AnnaAlina/4-story-Elevator_PLC-Arduino/Elevator Pictures/Elevator Front.jpg

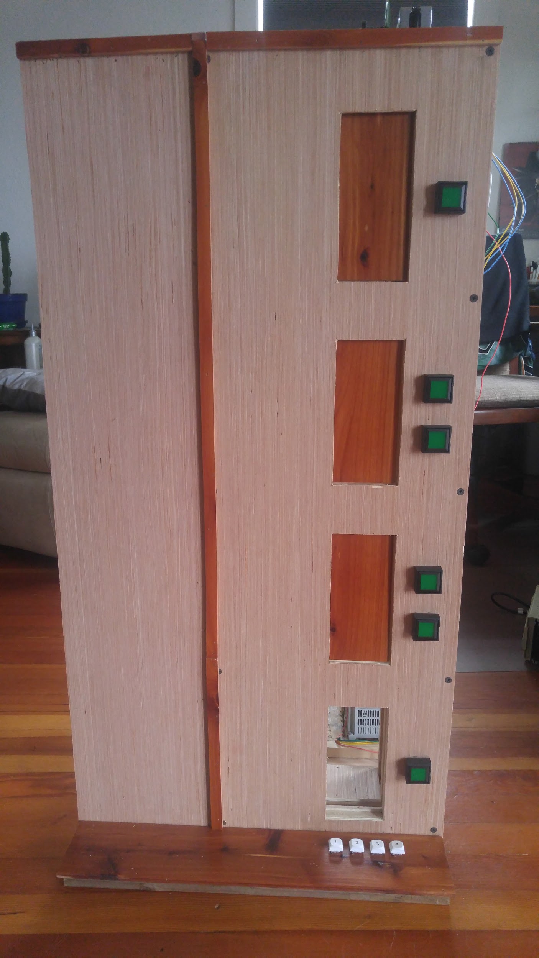
Elevator Pictures/Elevator Front.jpg
