AnnaAlina/4-story-Elevator_PLC-Arduino/Elevator Pictures/Motor and pulley.png

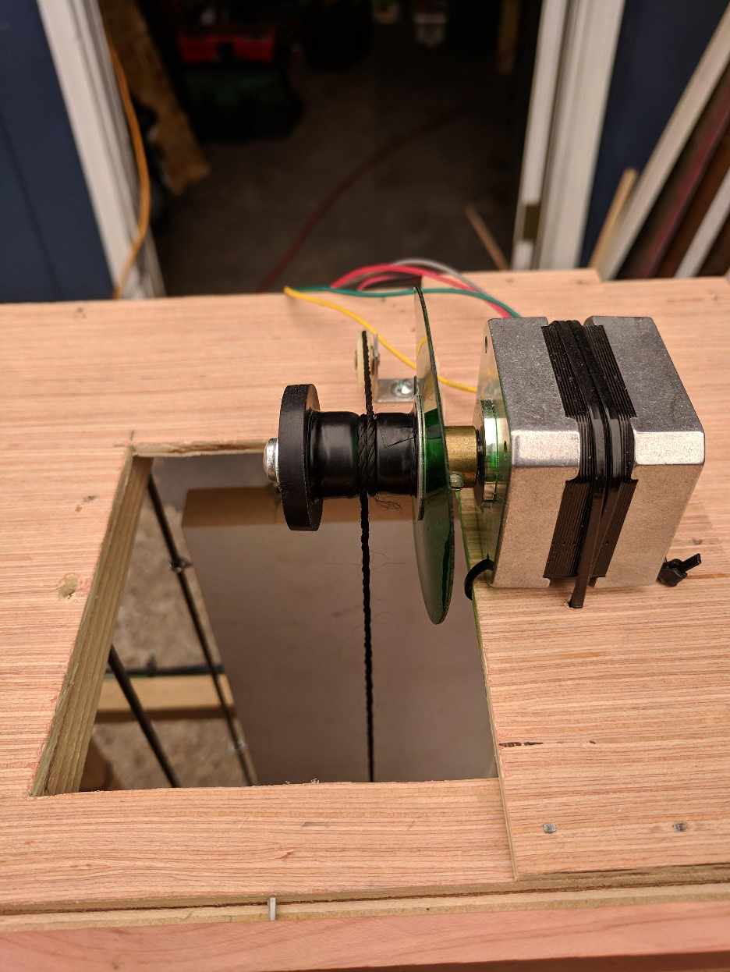
Elevator Pictures/Motor and pulley.png
