AnnaAlina/4-story-Elevator_PLC-Arduino/Elevator Flow charts and Block Diagrams/Block Diagram.jpg

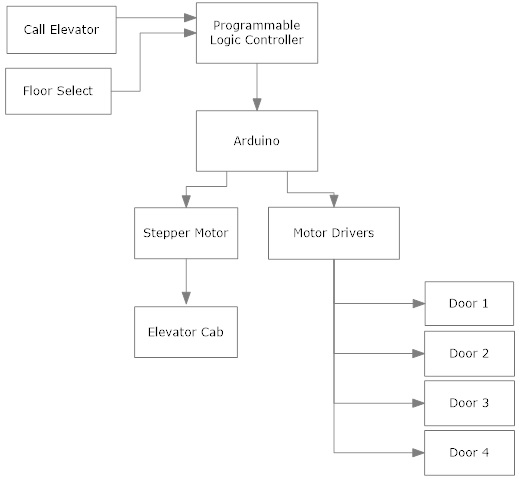
Elevator Flow charts and Block Diagrams/Block Diagram.jpg
