AnnaAlina/4-story-Elevator_PLC-Arduino/Elevator Flow charts and Block Diagrams/Connection Diagram.png

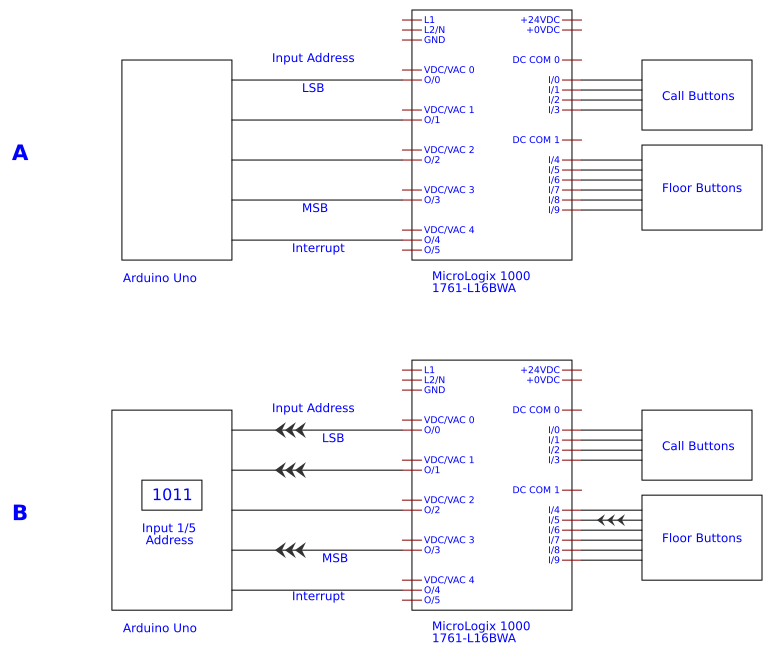
Elevator Flow charts and Block Diagrams/Connection Diagram.png
