AnnaAlina/4-story-Elevator_PLC-Arduino/Elevator Flow charts and Block Diagrams/UpDown Button Pinout.jpg

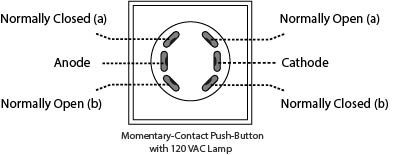
Elevator Flow charts and Block Diagrams/UpDown Button Pinout.jpg
