AnnaAlina/4-story-Elevator_PLC-Arduino/Schematic_Elevator.png

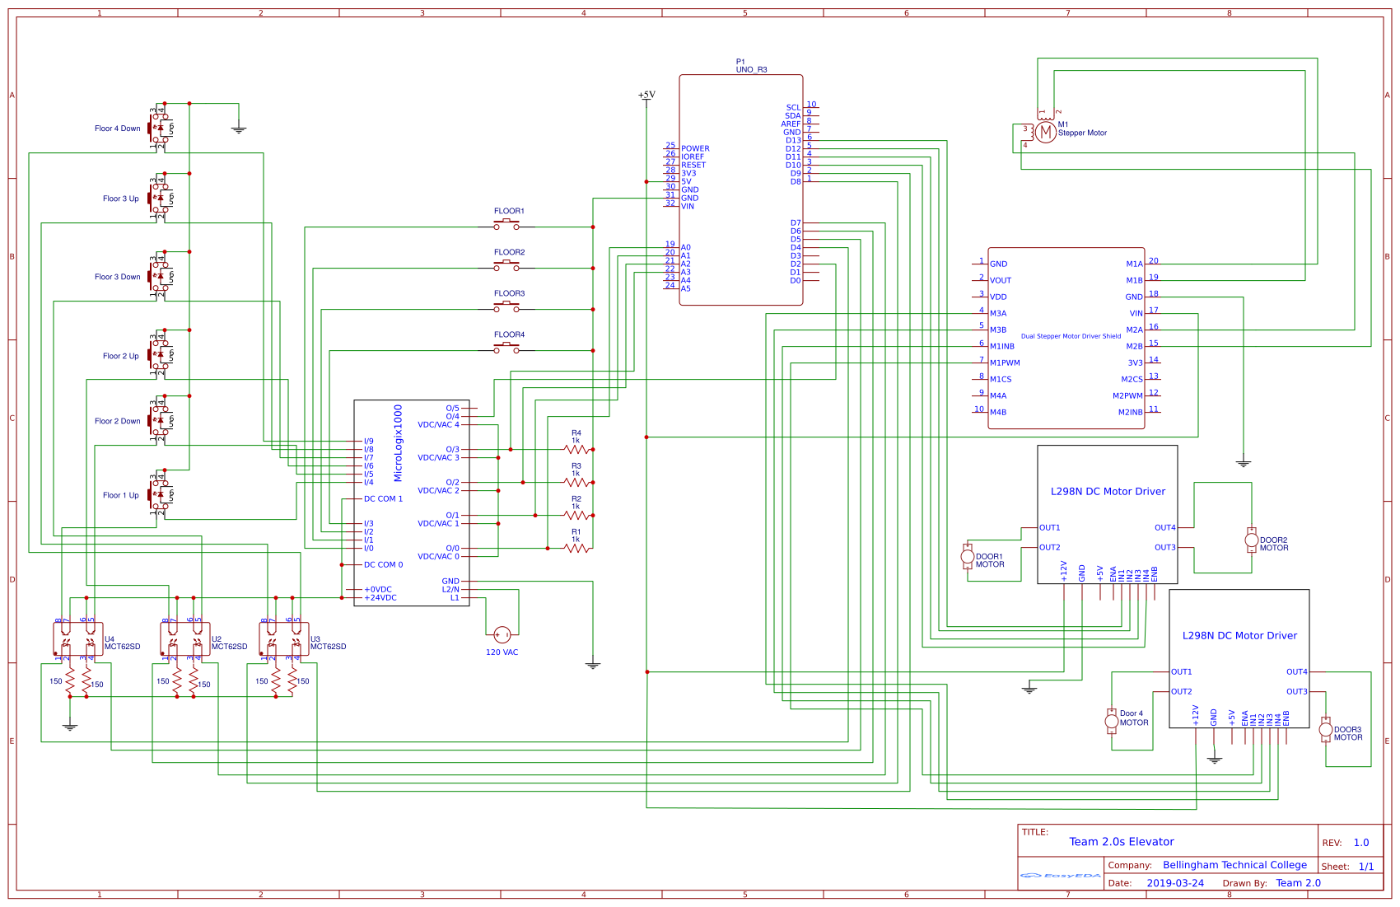
Schematic_Elevator.png
